f3l1xa88077/Power-Supply/Images/Schematic.pdf

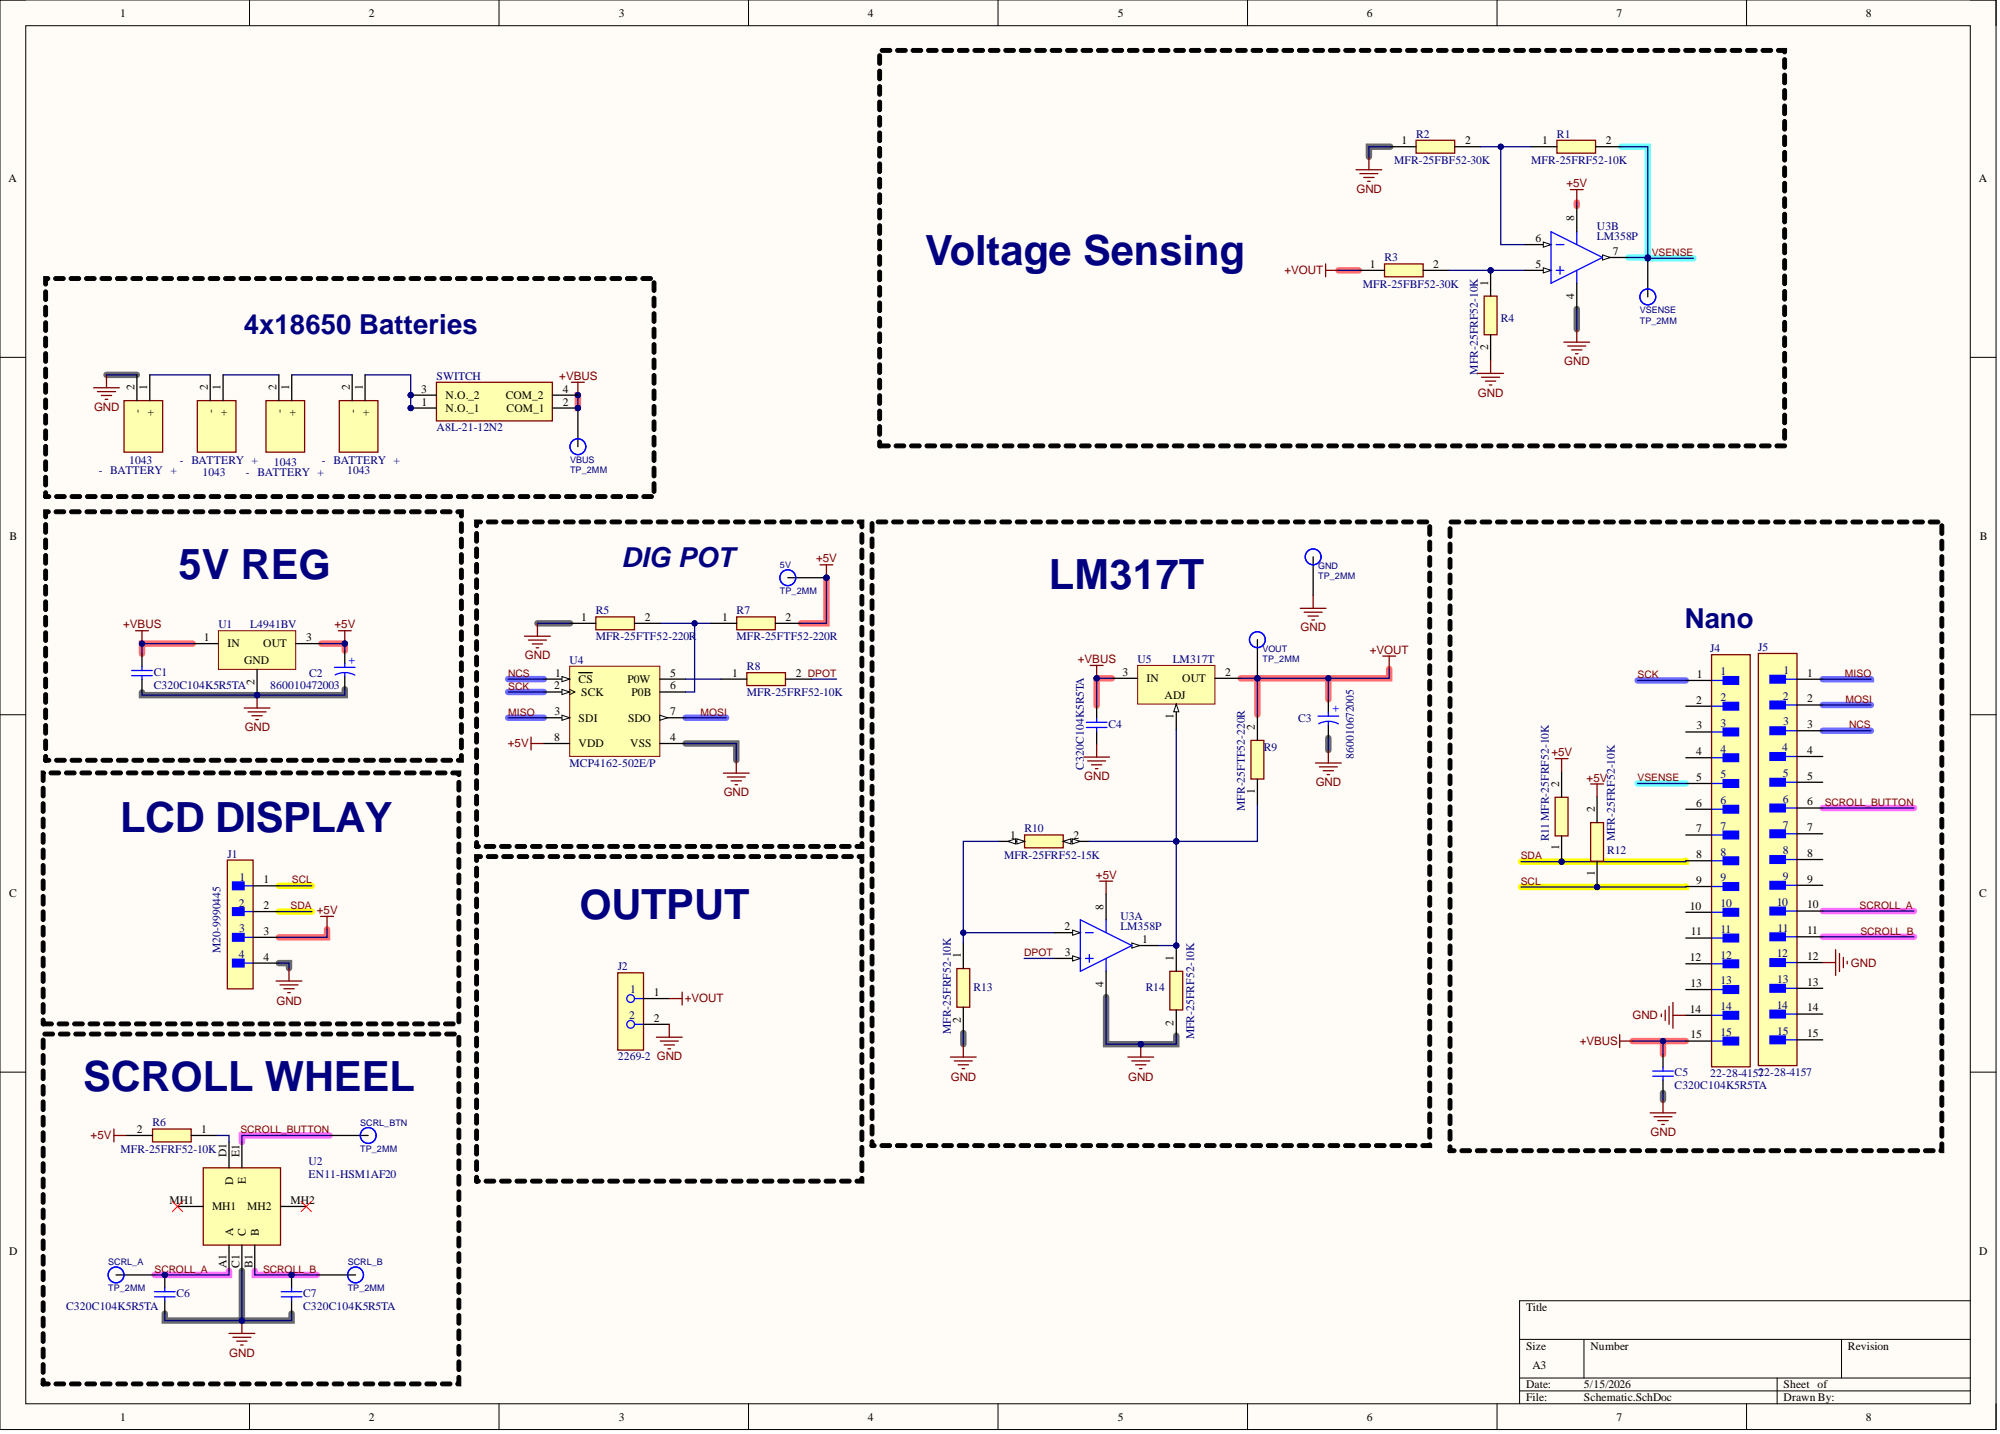
[picture p5: page 1]
