f3l1xa88077/Power-Supply/Arduino/Arduino.ino

// -------- I2C --------

#include <Wire.h>
#include <LiquidCrystal_I2C.h>

// -------- SPI --------
#include <SPI.h>

// -------- Voltage Configuration --------
const float min_voltage = 2.40;
const float max_voltage = 6.0;

// -------- Voltage Pin Configuration --------
int vsense_pin = A1;
volatile float vsense;

// -------- I2C Configuration --------
int sda = 18;
int scl = 19;
LiquidCrystal_I2C lcd(0x27, 16, 2);

// -------- Rotary Encoder Configuration --------
const int RE_A = 3;
const int RE_B = 2;
const int RE_Btn = 7;

volatile float prev_voltage = -1;
volatile float desired_voltage = 2.5;

// -------- SPI Configuration --------
int sck = 13;
int miso = 12;
int ncs = 10;
uint8_t mcp_val = 220;

void setup() {

  // -------- PIN I/O --------
  pinMode(vsense_pin, INPUT);

  // -------- Serial --------
  Serial.begin(9600);

  // -------- SPI --------
  pinMode(ncs, OUTPUT);
  pinMode(sck, OUTPUT);
  pinMode(12, OUTPUT); // Use Pin 12 (MISO track) as your Data Out
  pinMode(11, INPUT);  // Set Pin 11 (MOSI track) to INPUT so it doesn't short
  digitalWrite(ncs, HIGH); // Disable Slave Select

  // -------- I2C --------
  lcd.init();
  lcd.backlight();
  lcd.print("Startup...");

  // -------- Rotary Encoder --------
  pinMode(RE_A, INPUT_PULLUP);
  pinMode(RE_B, INPUT_PULLUP);

  attachInterrupt(digitalPinToInterrupt(RE_A), readEncoderISR, CHANGE);

  delay(500);

}

void loop() {

  if (desired_voltage != prev_voltage) { // Execute code only if a change in input is detected

    // -------- LCD --------
    float set_voltage = desired_voltage; // Save current voltage so it isn't overwritten
    lcd.clear();
    lcd.setCursor(0, 0);
    lcd.print("INPUT: ");
    lcd.print(set_voltage);
    lcd.print(" V   "); // Clear trailing digits

    // -------- VOLTAGE SENSING --------
    vsense = vsense_voltage(vsense_pin);

    // -------- FEEDBACK --------

    // Calculate Error
    volatile float cur_err = vsense - set_voltage;
    float prev_err = 999.0;
    uint8_t best_mcp = mcp_val;

    while ((fabs(cur_err) < fabs(prev_err)) || (fabs(cur_err) > 0.2)) { // If still converging or if very far away

      // Calculate how many steps to take
      int steps = calculate_steps(set_voltage, cur_err);

      // Calculate New Rheostat Value
      prev_err = cur_err;
      best_mcp = mcp_val;
      mcp_val += steps;

      // Send new Rheo value
      mcp_val = constrain(mcp_val, 0, 255);
      slowMCPWrite(mcp_val);

      // Small Delay for Circuit Stabilisation
      delay(5);

      // Calculate Error
      vsense = vsense_voltage(vsense_pin);
      cur_err = vsense - set_voltage;

      // Print Error
      Serial.print("Not Converged... Error is: ");
      Serial.print(cur_err);
      Serial.print(" | Step: ");
      Serial.print(steps);
      Serial.print(" | MCP: ");
      Serial.println(mcp_val);

    }

    mcp_val = best_mcp;
    slowMCPWrite(mcp_val);
    delay(5);
    vsense = vsense_voltage(vsense_pin);
    Serial.print("Converged... Voltage: ");
    Serial.println(vsense);

    // -------- LCD --------
    lcd.setCursor(0, 1);
    lcd.print("OUTPUT: ");
    lcd.print(vsense);
    lcd.print(" V   "); // Clear trailing digits

    // Update State
    prev_voltage = set_voltage;

  }

}

// -------------------------- Analog ---------------------------

float vsense_voltage(int vsense_pin) {
  int vsense_adc = analogRead(vsense_pin);
  return (float)vsense_adc * 5.0 * 3.0 / 1023.0 + 0.05; // 0.05 from experimental testing
}

// -------------------------- ISR ---------------------------

void readEncoderISR() {
  // Triggered by Pin A changing
  int aState = digitalRead(RE_A);
  int bState = digitalRead(RE_B);

  if (aState != bState) {
    desired_voltage -= 0.1;
  } else {
    desired_voltage += 0.1;
  }

  desired_voltage = constrain(desired_voltage, min_voltage, max_voltage);
}

// -------------------------- MCP Functions ---------------------------

int calculate_steps(float voltage, float err) {
  float num = 20 * err;
  float den = 1 * (voltage - 2.2); // Voltage can only be minimum of 2.5, so we avoid divide by 0 error
  int steps = num / den;
  if (steps == 0) {
    steps = (err > 0) ? 1 : -1;
  }
  return steps;
}

void slowMCPWrite(byte data) {
  digitalWrite(ncs, LOW);
  delayMicroseconds(10); 

  // Address 0x00 (Wiper 0)
  shiftOutManual(miso, sck, MSBFIRST, 0x00); 
  // Data 0-255
  shiftOutManual(miso, sck, MSBFIRST, data);

  delayMicroseconds(10);
  digitalWrite(ncs, HIGH);
}

void shiftOutManual(uint8_t dataPin, uint8_t clockPin, uint8_t bitOrder, uint8_t val) {
  for (uint8_t i = 0; i < 8; i++)  {
    if (bitOrder == LSBFIRST)
      digitalWrite(dataPin, !!(val & (1 << i)));
    else      
      digitalWrite(dataPin, !!(val & (1 << (7 - i))));
      
    digitalWrite(clockPin, HIGH);
    delayMicroseconds(10); // Faster than 1Hz but still very safe
    digitalWrite(clockPin, LOW);
    delayMicroseconds(10);
  }
}

int calcResistance(float voltage) {
  // Base Cases
  if (voltage > 6.0) {return 0;}
  if (voltage < 2.0) {return 10000;}

  float num = 12.5*220;
  float den = voltage - 1.25;
  return num / den - 440;
}
