f3l1xa88077/Power-Supply/(commit log)

2026-05-12 Added Arduino file and got vsense working.
2026-05-13 Introduced Rotary Encoder and Interrupt working, subject to bounce.
2026-05-13 Operational voltage regulation, not accurate.
2026-05-13 Feedback control, 128 tap working. Excel data analysis started for no feedback and 128 tap.
    [Data.xlsx]
2026-05-14 Desired voltage set to 0.2V increments
    [Data.xlsx]
2026-05-14 Desired voltage clamped to 2.0 - 6.0 V.
2026-05-14 LCD Display set-up with I/O voltage.
2026-05-14 Feedback loop working within 0.1V to VSENSE
2026-05-14 Data gathered and Vsense offset added. Vsense is very close to Vout
    [Data.xlsx]
2026-05-15 Finished README, updated Data.xlsx with updated feedback loop data. Added images. Added Altium project file.
    [Data.xlsx]
